mourix/jvMacro/Hardware/JvMacro_BOM_R1.pdf

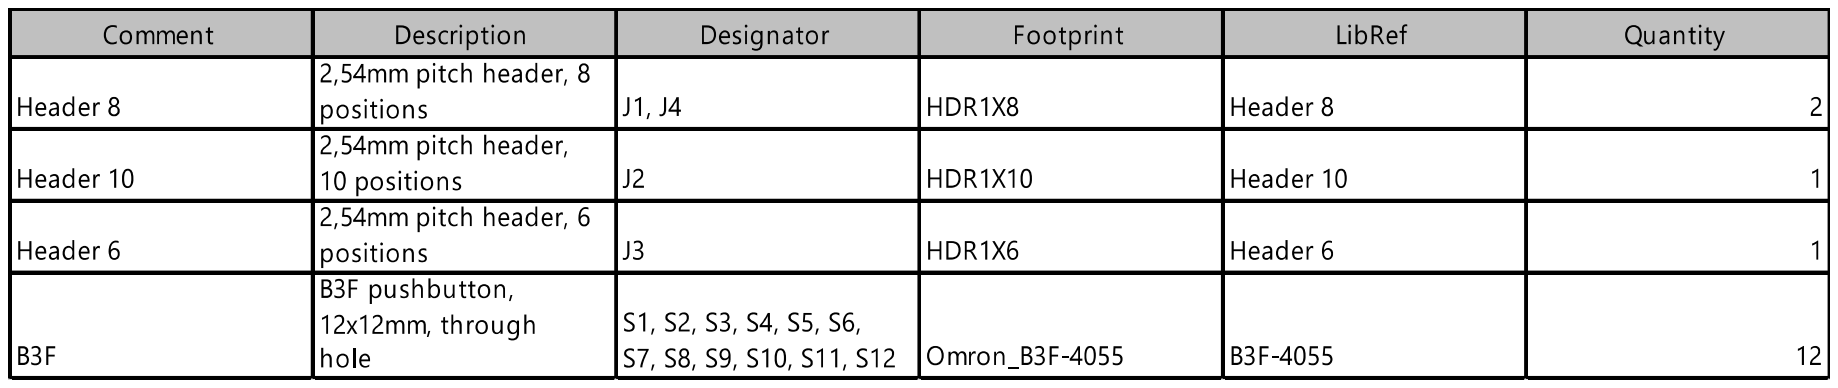
[picture p2: page 1]
