mourix/jvMacro/Hardware/JvMacro_Schematic_R1.pdf

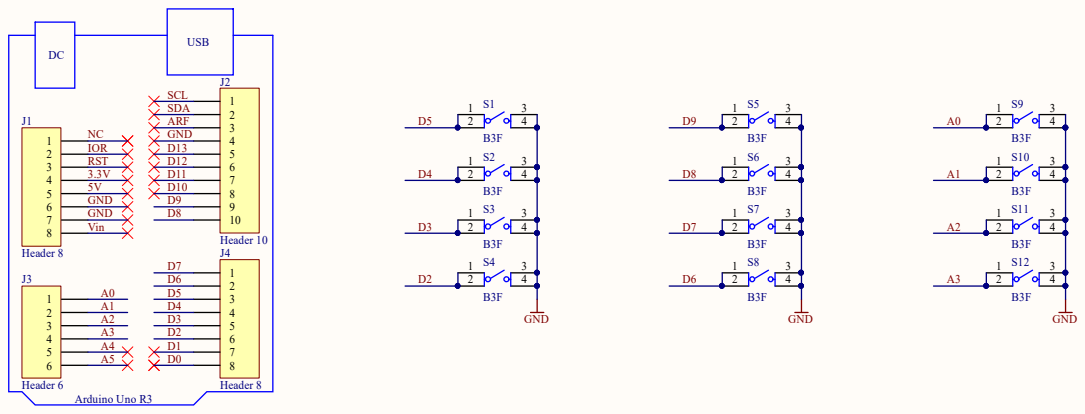
[picture p3: page 1]
