mourix/jvMacro/ButtonLabels/JvMacro_Label_Print_Example.pdf

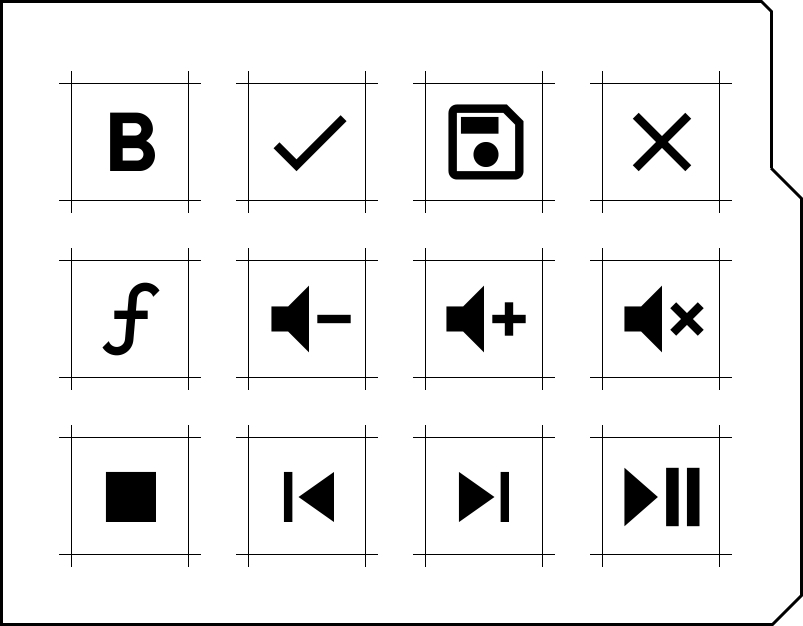
[picture p4: page 1]
