mourix/jvMacro/ButtonLabels/JvMacro_Label_Print_Template.png

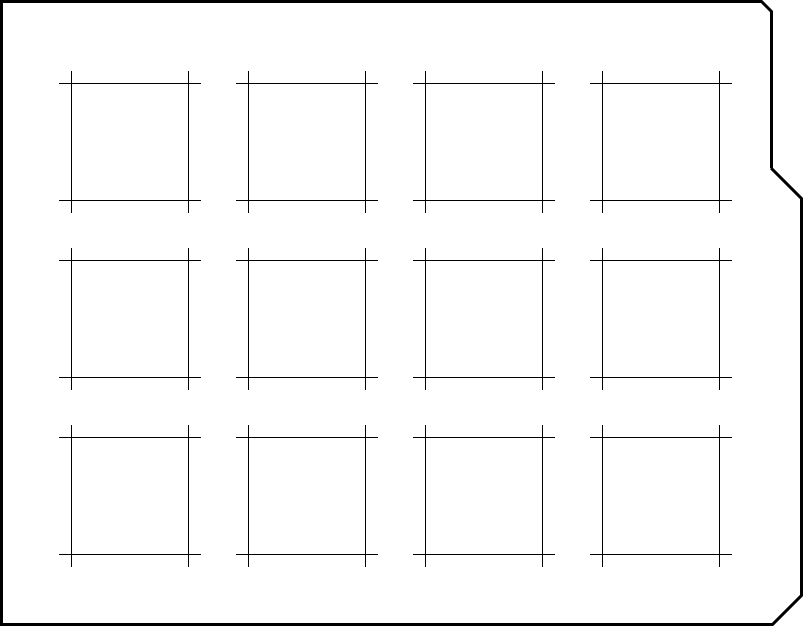
ButtonLabels/JvMacro_Label_Print_Template.png
